timothyosm/tifa6-acrylic-speaker/docs/current/hardware.md

# Hardware for one enclosure

Current build: **72 M3 screws** (56 x M3-16, 8 x M3-10, 4 x M3-20, 4 x M3-6), 60 inserts and 4 nuts. Lengths are under-head dimensions in mm. Use ordinary socket/button heads, never countersunk; verify head fit in the real driver recesses.

| Qty | Item | Purpose |
|---:|---|---|
| 32 | M3 x 16 screw | Side/front/rear to rails |
| 8 | M3 x 16 screw | Top/bottom to rails |
| 4 | M3 x 16 screw | Brace to shelves |
| 8 | M3 x 16 screw | Adapters to front |
| 4 | M3 x 16 screw | Rear to crossover spacers |
| 8 | M3 x 10 screw | Drivers |
| 4 | M3 x 20 screw | Port flange |
| 4 | M3 x 6 screw | Crossover board |
| 60 | M3 heat-set insert, 4 mm long | Printed fittings; 4.2 mm pilots |
| 4 | M3 plain nut | Port flange |
| 64 | 9 mm OD M3 flat washer | 60 sheet-side heads + 4 port flange rear washers |
| 60 | Compatible cushioning washer | Sheet-side heads; metal+cushion stack 1.5 mm |
| 4 | M3 female/female 20 mm spacer | Crossover |
| 2 | Insulated binding post for 8 mm opening | Own nuts and seals |
| 1 | 120 x 90 x 2 insulating board | 100 x 70 mm mounting pattern |

Also supply compatible closed-cell foam, thin driver gaskets, removable sealant, porous lining and wire. All panel assembly uses M3 screws; no structural glue is required. Select the actual washers to give the modelled 1.5 mm head-side metal/cushion stack. Inserts are 4 mm long in 4.2 mm pilots. Test retention and tighten gently; no torque rating has been physically qualified. Binding posts use their own supplied hardware.
