timothyosm/tifa6-acrylic-speaker/docs/source-register.md

# Sources

- [Tifa 6 cabinet drawing](https://sbacoustics.com/wp-content/uploads/2026/05/Tifa-6-cabinet-drawing.pdf): cabinet baseline, driver positions and port.
- [SB16PFCR25-4](https://sbacoustics.com/wp-content/uploads/2024/01/6in-SB16PFCR25-4.pdf): woofer dimensions.
- [SB26ST-C000-5](https://sbacoustics.com/wp-content/uploads/2020/02/SB26ST-C000-5.pdf): tweeter dimensions.
- [Tifa 6 crossover](https://sbacoustics.com/wp-content/uploads/2025/12/Tifa-6-Crossover-Schematic.pdf): unchanged electrical design.

Manufacturer PDFs are available at the official links above; local reference copies are not redistributed in this repository. Hardware fits are nominal and need a physical dry fit.

## Acrylic fabrication

- [PLEXIGLAS drilling guidance](https://www.plexiglas.de/en/service/processing/drilling-plexiglas): minimum hole-centre edge distance of 1.5 times hole diameter; appropriate drilling methods for the actual sheet.
- [PLEXIGLAS fastening guidance](https://www.plexiglas.de/en/service/processing/fastening-and-laying-plexiglas): allow thermal movement and use compatible fastening methods.
- [Perspex design guide](https://www.perspex.co.uk/Perspex/media/General/technical-library/PDFs/Perspex-Design-Guide.pdf): acrylic design and fabrication reference. Confirm actual grade and fabricator requirements.

The rectangular 220 mm baffle, 10 mm acrylic panels, lower port position, printed adapters and M3 rails are project adaptations. The flat panel STLs provide dimensional references. Profiles are uncompensated; measured sheet thickness and laser kerf must be confirmed using the supplied coupon. No physical acoustic equivalence to the original cabinet is claimed.
