timothyosm/tifa6-acrylic-speaker/renders/exploded.png

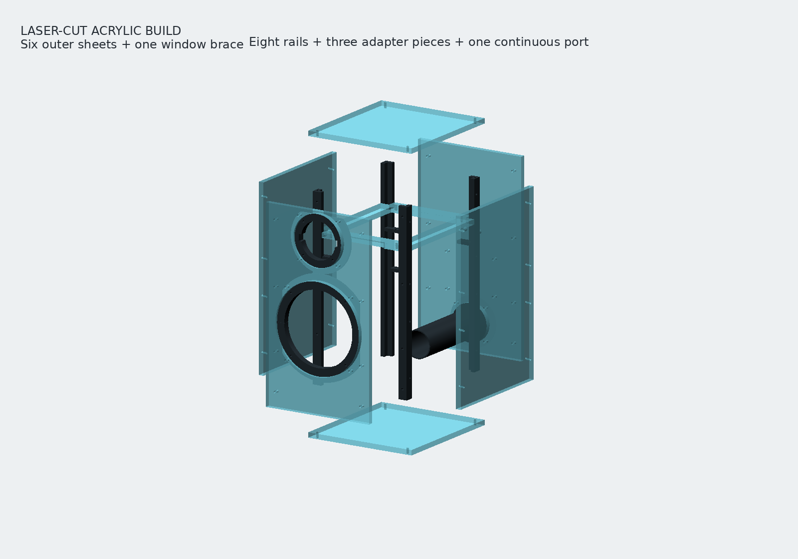
renders/exploded.png
