timothyosm/tifa6-acrylic-speaker/renders/rear.png

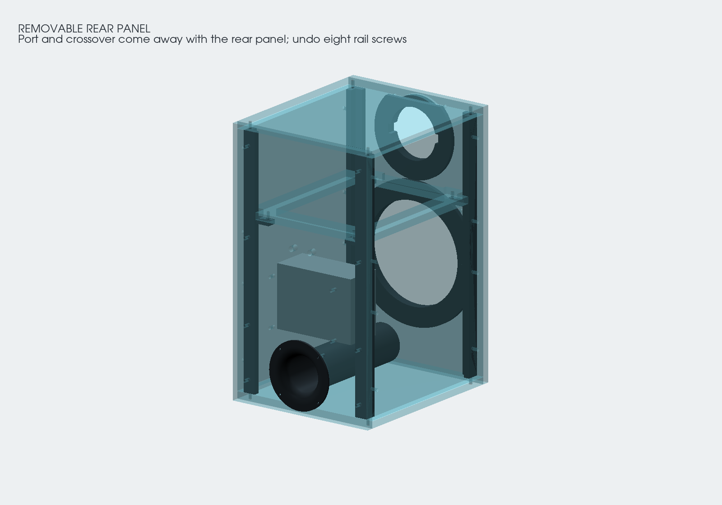
renders/rear.png
