timothyosm/tifa6-acrylic-speaker/renders/sectional.png

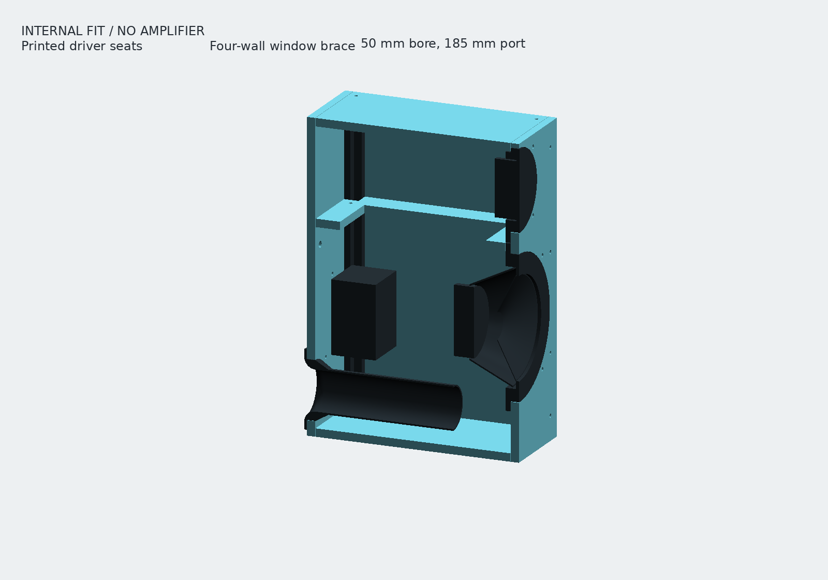
renders/sectional.png
