timothyosm/tifa6-acrylic-speaker/exports/current/print-manifest.csv

file | quantity | kind | size_x_mm | size_y_mm | size_z_mm
front.stl | 1 | sheet | 220.0 | 380.0 | 10.0
rear.stl | 1 | sheet | 220.0 | 380.0 | 10.0
left.stl | 1 | sheet | 241.65216064453125 | 359.0 | 10.0
right.stl | 1 | sheet | 241.65216064453125 | 359.0 | 10.0
bottom.stl | 1 | sheet | 220.0 | 241.65216064453125 | 10.0
top.stl | 1 | sheet | 220.0 | 241.65216064453125 | 10.0
brace.stl | 1 | sheet | 199.0 | 240.65216064453125 | 10.0
rail_left_front_lower.stl | 1 | printed_fitting | 139.6535949707031 | 139.65359497070312 | 18.0
rail_left_front_upper.stl | 1 | printed_fitting | 139.65359497070312 | 139.65359497070312 | 38.0
rail_left_rear_lower.stl | 1 | printed_fitting | 139.65359497070312 | 139.65359497070312 | 18.0
rail_left_rear_upper.stl | 1 | printed_fitting | 139.65359497070312 | 139.65359497070312 | 38.0
rail_right_front_lower.stl | 1 | printed_fitting | 139.65359497070312 | 139.65359497070312 | 18.0
rail_right_front_upper.stl | 1 | printed_fitting | 139.65359497070312 | 139.65359497070312 | 38.0
rail_right_rear_lower.stl | 1 | printed_fitting | 139.65359497070312 | 139.65359497070312 | 18.0
rail_right_rear_upper.stl | 1 | printed_fitting | 139.65359497070312 | 139.65359497070312 | 38.0
tweeter_adapter.stl | 1 | printed_fitting | 125.99989093116892 | 112.98756784386933 | 13.5
woofer_adapter_lower.stl | 1 | printed_fitting | 175.99989318847656 | 99.9000015258789 | 12.899999618530273
woofer_adapter_upper.stl | 1 | printed_fitting | 175.99989318847656 | 99.9000015258789 | 12.899999618530273
bass_reflex_port.stl | 1 | printed_fitting | 96.0 | 95.98102086223662 | 184.99999989999998
