timothyosm/tifa6-acrylic-speaker/cad/speaker_assembly.FCStd

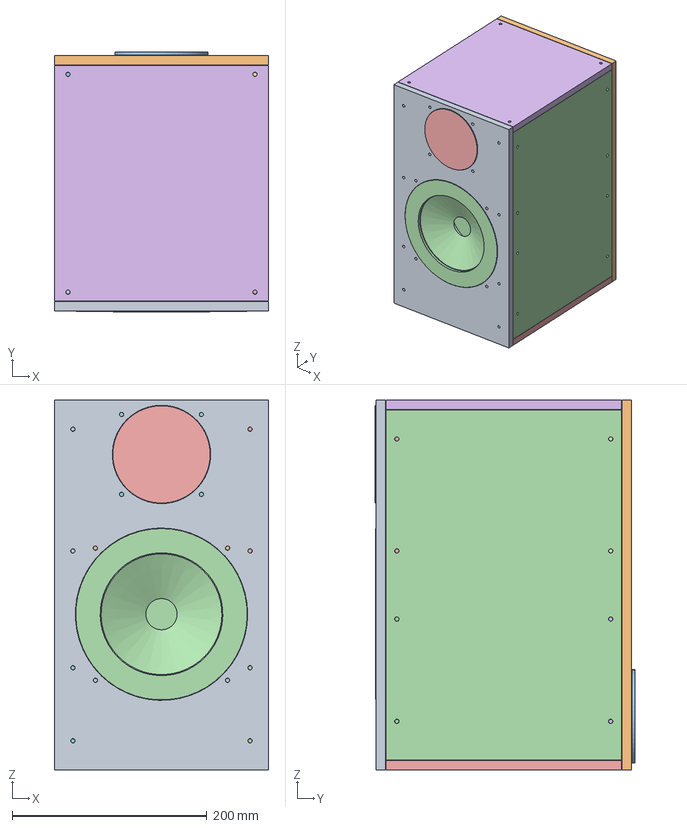
[picture p5: CAD file, 2026-10-10]
cad/speaker_assembly.FCStd
220.0 x 267.2 x 380.0 mm
front
rear
left
right
bottom
top
brace
rail_left_front_lower
rail_left_front_upper
rail_left_rear_lower
rail_left_rear_upper
rail_right_front_lower
rail_right_front_upper
rail_right_rear_lower
rail_right_rear_upper
tweeter_adapter
woofer_adapter_lower
woofer_adapter_upper
bass_reflex_port
reference_woofer
reference_tweeter
reference_crossover
reference_spacers
