timothyosm/tifa6-acrylic-speaker/exports/current/step/enclosure_assembly.step

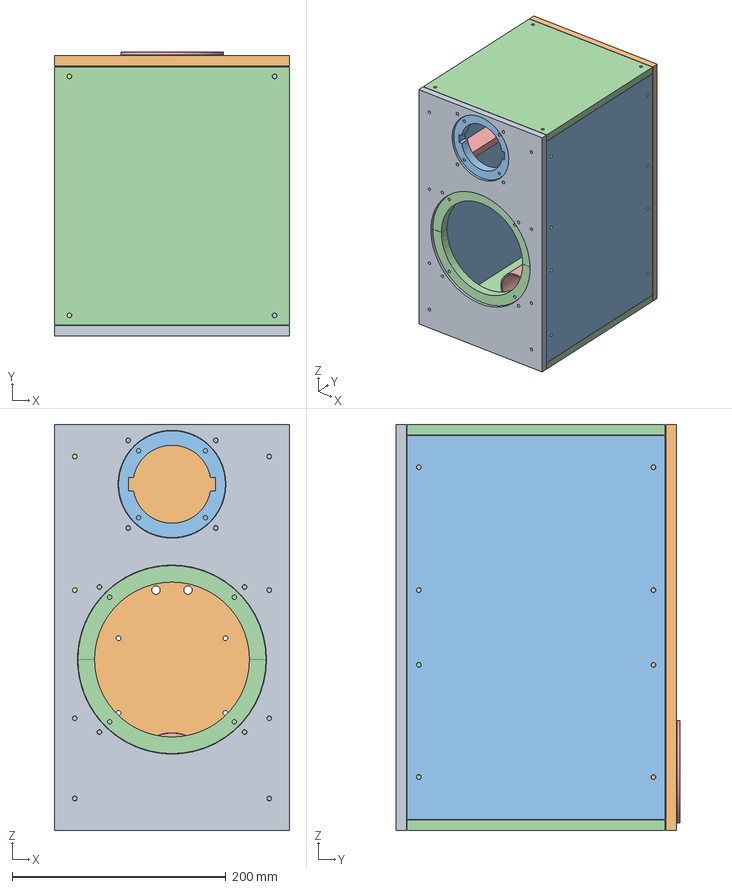
[picture p6: CAD file, 2026-10-10]
exports/current/step/enclosure_assembly.step
220.0 x 266.2 x 380.0 mm
