timothyosm/tifa6-acrylic-speaker/exports/calibration/laser/sheet_fit_coupon.dxf

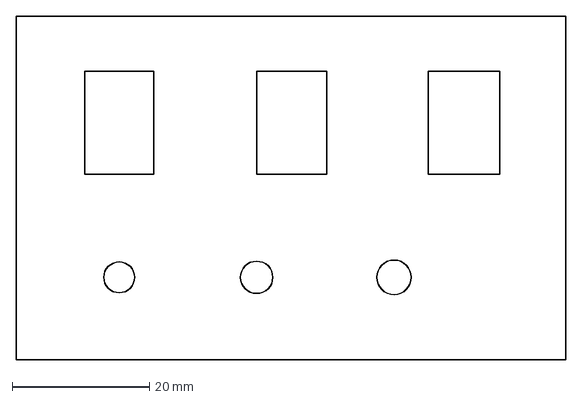
[picture p7: CAD file, 2026-10-10]
exports/calibration/laser/sheet_fit_coupon.dxf
80.0 x 50.0 mm
