timothyosm/tifa6-acrylic-speaker/exports/calibration/stl/sheet_fit_coupon.stl

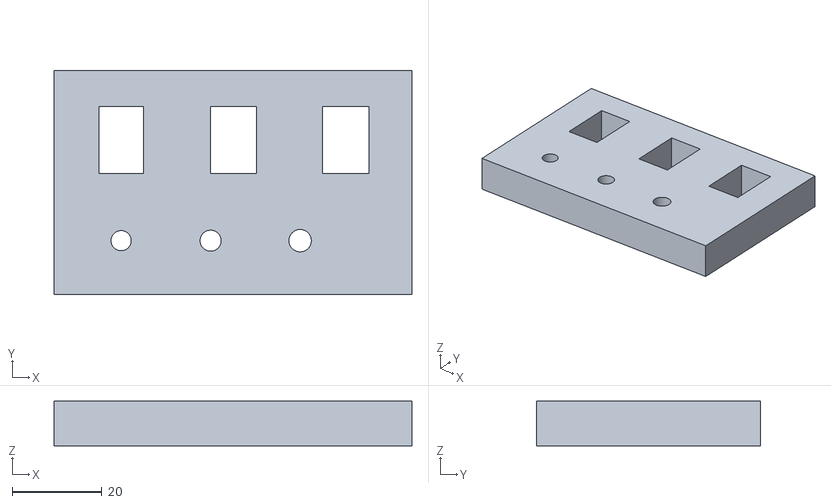
[picture p8: CAD file, 2026-10-10]
exports/calibration/stl/sheet_fit_coupon.stl
80.0 x 50.0 x 10.0
