timothyosm/tifa6-acrylic-speaker/exports/current/laser/brace.dxf

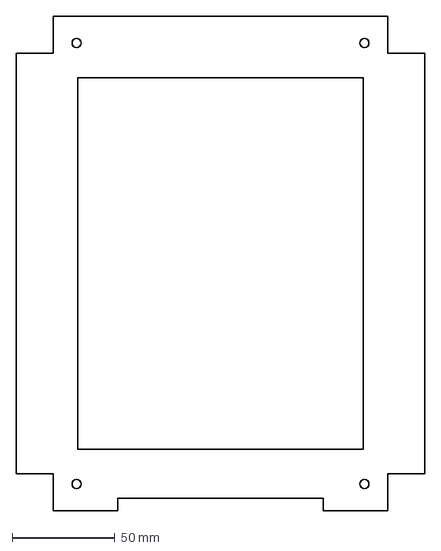
[picture p9: CAD file, 2026-10-10]
exports/current/laser/brace.dxf
199.0 x 240.7 mm
