timothyosm/tifa6-acrylic-speaker/exports/current/step/top.step

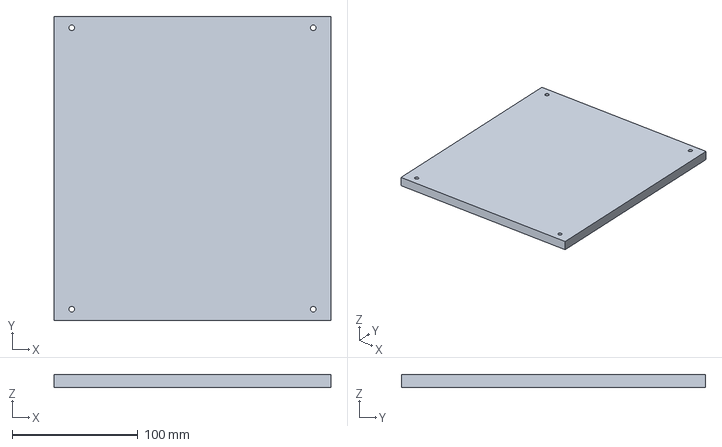
[picture p10: CAD file, 2026-10-10]
exports/current/step/top.step
220.0 x 241.7 x 10.0 mm
