timothyosm/tifa6-acrylic-speaker/exports/current/laser/left.dxf

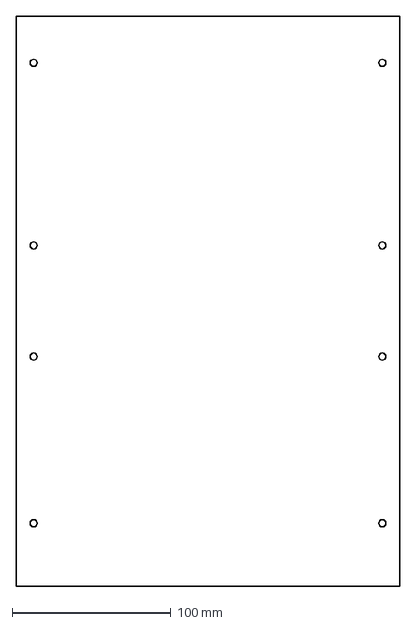
[picture p11: CAD file, 2026-10-10]
exports/current/laser/left.dxf
241.7 x 359.0 mm
