timothyosm/tifa6-acrylic-speaker/exports/current/step/rail_left_rear_lower.step

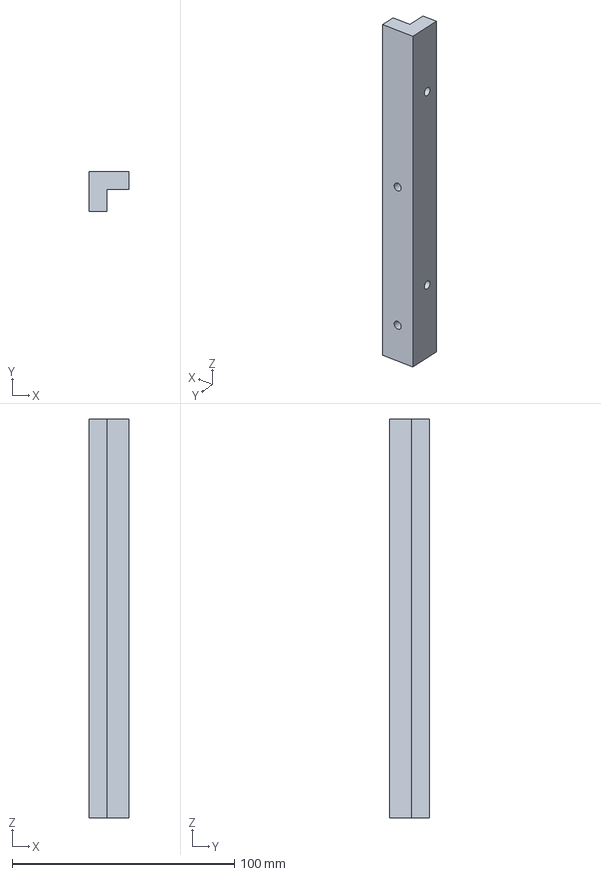
[picture p12: CAD file, 2026-10-10]
exports/current/step/rail_left_rear_lower.step
18.0 x 18.0 x 179.5 mm
