timothyosm/tifa6-acrylic-speaker/exports/current/laser/right.dxf

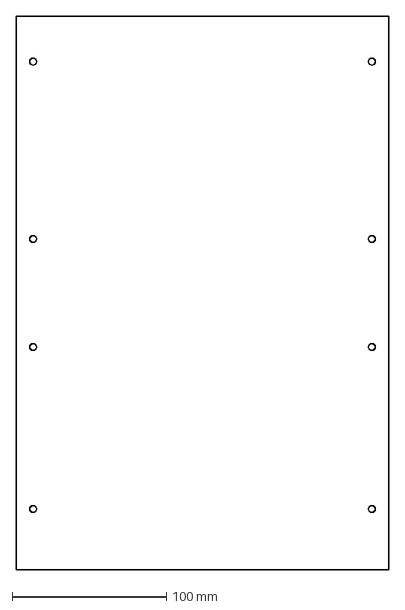
[picture p13: CAD file, 2026-10-10]
exports/current/laser/right.dxf
241.7 x 359.0 mm
