timothyosm/tifa6-acrylic-speaker/exports/current/step/reference_tweeter.step

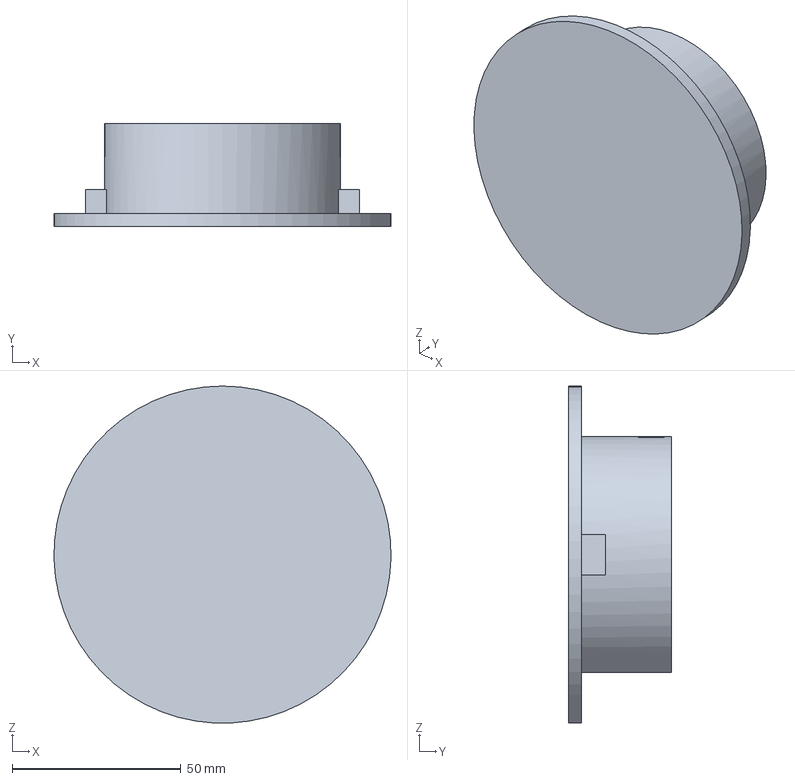
[picture p14: CAD file, 2026-10-10]
exports/current/step/reference_tweeter.step
100.0 x 30.7 x 99.9 mm
