timothyosm/tifa6-acrylic-speaker/exports/current/laser/bottom.dxf

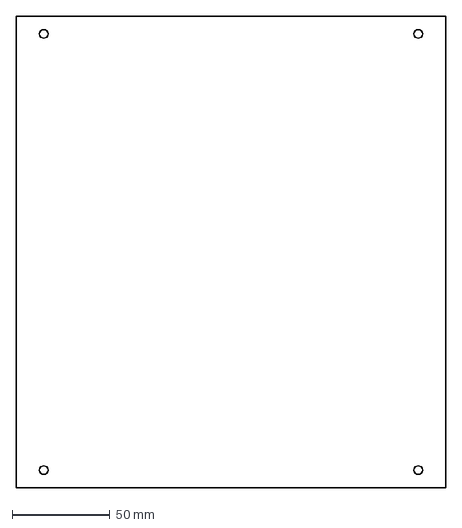
[picture p15: CAD file, 2026-10-10]
exports/current/laser/bottom.dxf
220.0 x 241.7 mm
