timothyosm/tifa6-acrylic-speaker/exports/current/step/reference_crossover.step

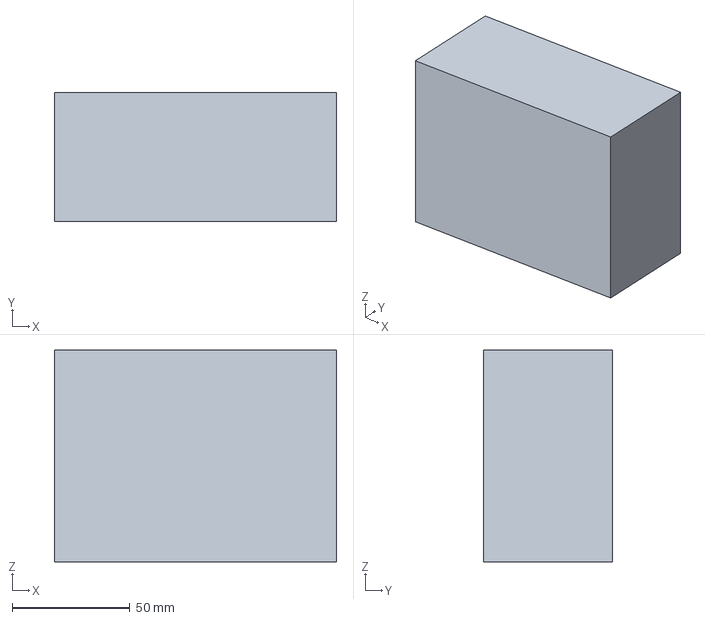
[picture p16: CAD file, 2026-10-10]
exports/current/step/reference_crossover.step
120.0 x 55.0 x 90.0 mm
