timothyosm/tifa6-acrylic-speaker/exports/current/laser/top.dxf

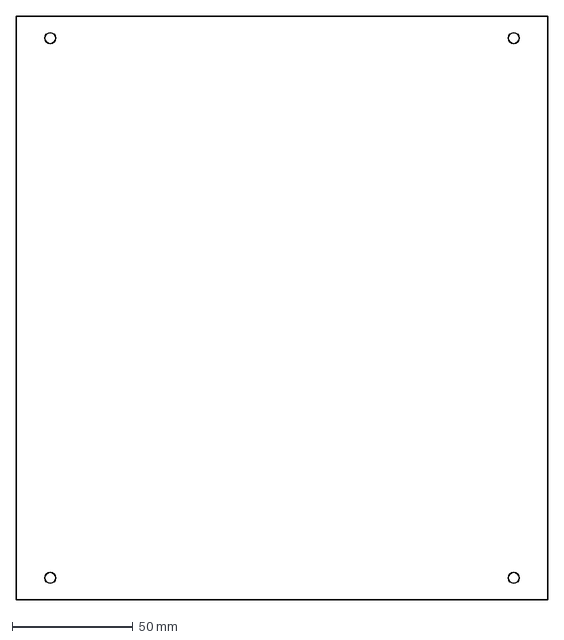
[picture p17: CAD file, 2026-10-10]
exports/current/laser/top.dxf
220.0 x 241.7 mm
