timothyosm/tifa6-acrylic-speaker/exports/current/step/reference_spacers.step

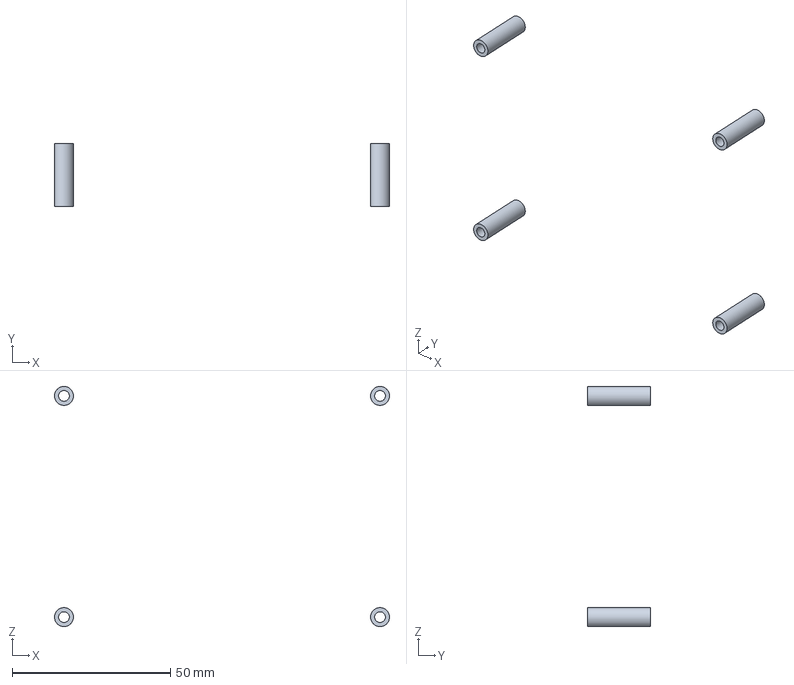
[picture p18: CAD file, 2026-10-10]
exports/current/step/reference_spacers.step
106.0 x 20.0 x 76.0 mm
