timothyosm/tifa6-acrylic-speaker/exports/current/laser/front.dxf

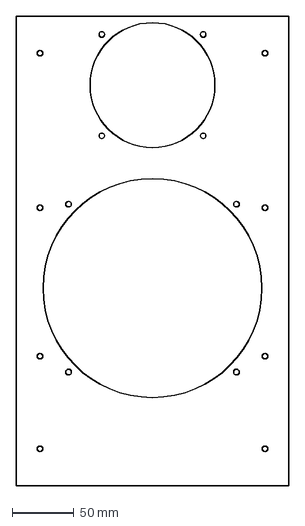
[picture p19: CAD file, 2026-10-10]
exports/current/laser/front.dxf
220.0 x 380.0 mm
