timothyosm/tifa6-acrylic-speaker/exports/current/step/woofer_adapter_upper.step

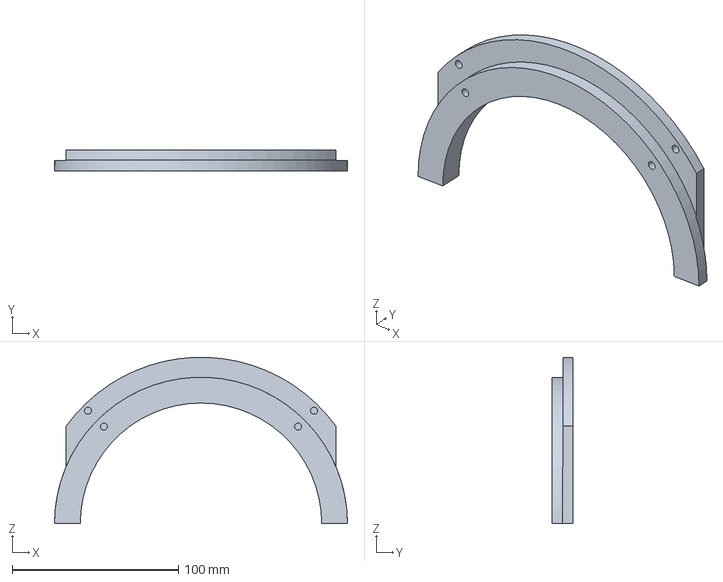
[picture p20: CAD file, 2026-10-10]
exports/current/step/woofer_adapter_upper.step
176.0 x 12.9 x 99.8 mm
