timothyosm/tifa6-acrylic-speaker/exports/current/laser/rear.dxf

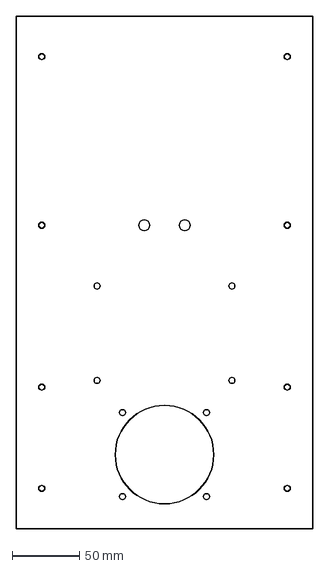
[picture p21: CAD file, 2026-10-10]
exports/current/laser/rear.dxf
220.0 x 380.0 mm
