timothyosm/tifa6-acrylic-speaker/exports/current/step/rail_right_rear_upper.step

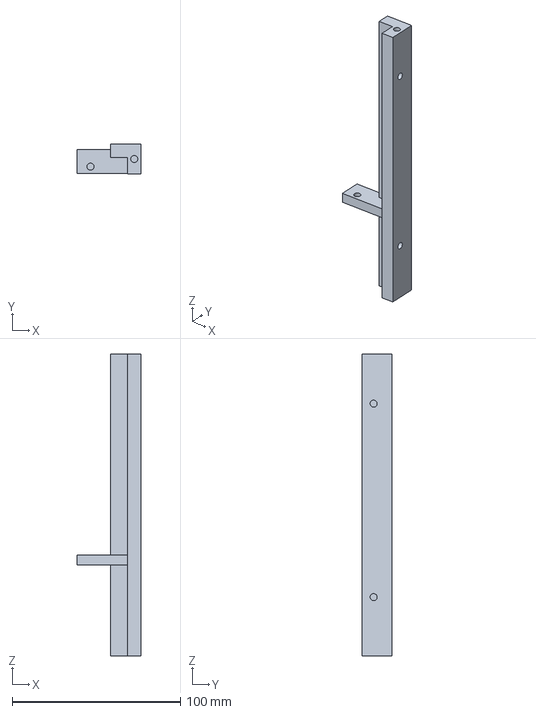
[picture p22: CAD file, 2026-10-10]
exports/current/step/rail_right_rear_upper.step
38.0 x 18.0 x 179.5 mm
