timothyosm/tifa6-acrylic-speaker/exports/current/step/rear.step

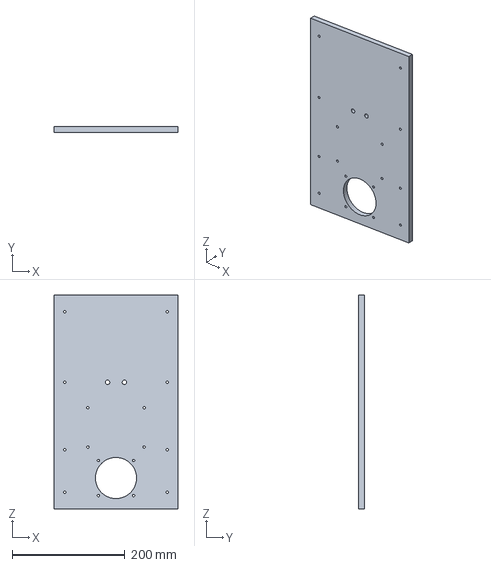
[picture p23: CAD file, 2026-10-10]
exports/current/step/rear.step
220.0 x 10.00 x 380.0 mm
