timothyosm/tifa6-acrylic-speaker/exports/current/step/brace.step

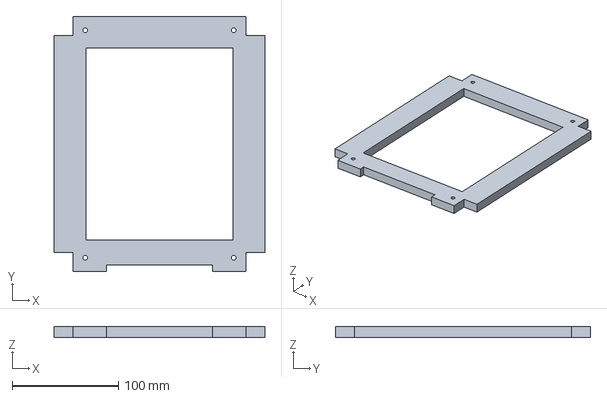
[picture p24: CAD file, 2026-10-10]
exports/current/step/brace.step
199.0 x 240.7 x 10.0 mm
