timothyosm/tifa6-acrylic-speaker/exports/current/step/nominal_air_volume.step

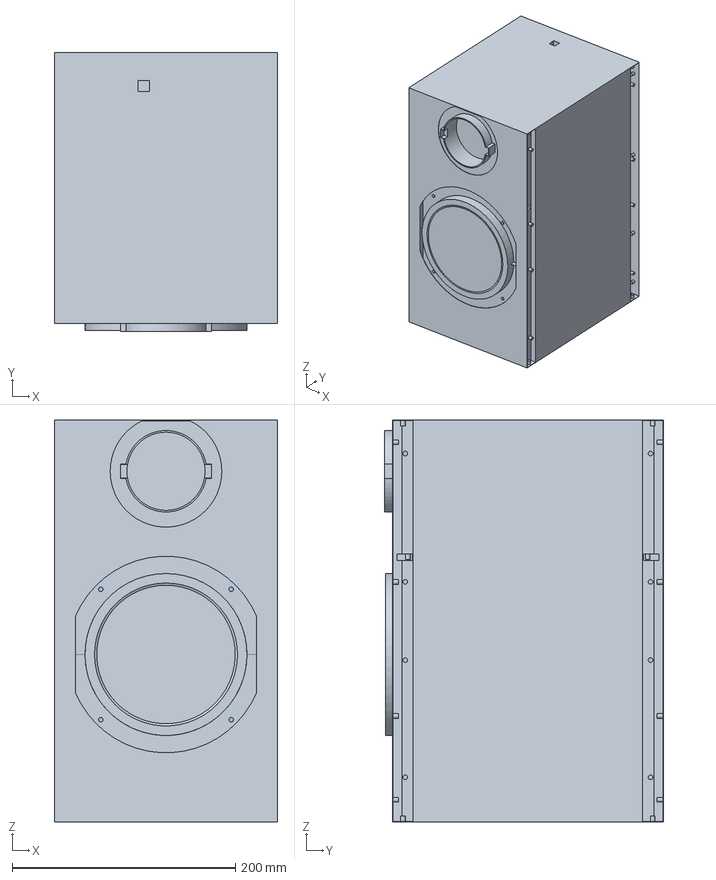
[picture p25: CAD file, 2026-10-10]
exports/current/step/nominal_air_volume.step
200.0 x 249.7 x 360.0 mm
