timothyosm/tifa6-acrylic-speaker/exports/current/step/left.step

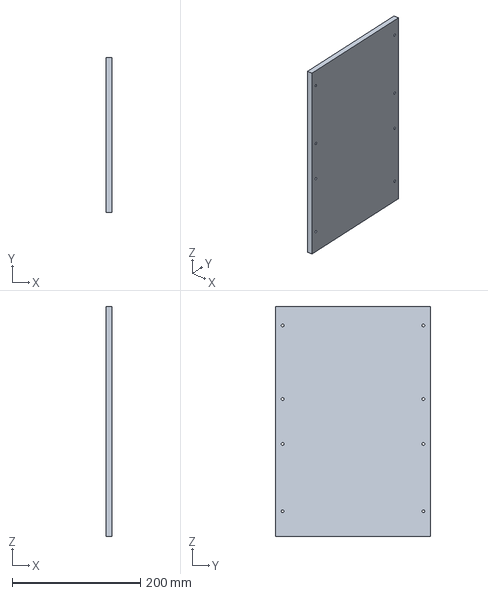
[picture p26: CAD file, 2026-10-10]
exports/current/step/left.step
10.0 x 241.7 x 359.0 mm
