timothyosm/tifa6-acrylic-speaker/exports/current/step/tweeter_adapter.step

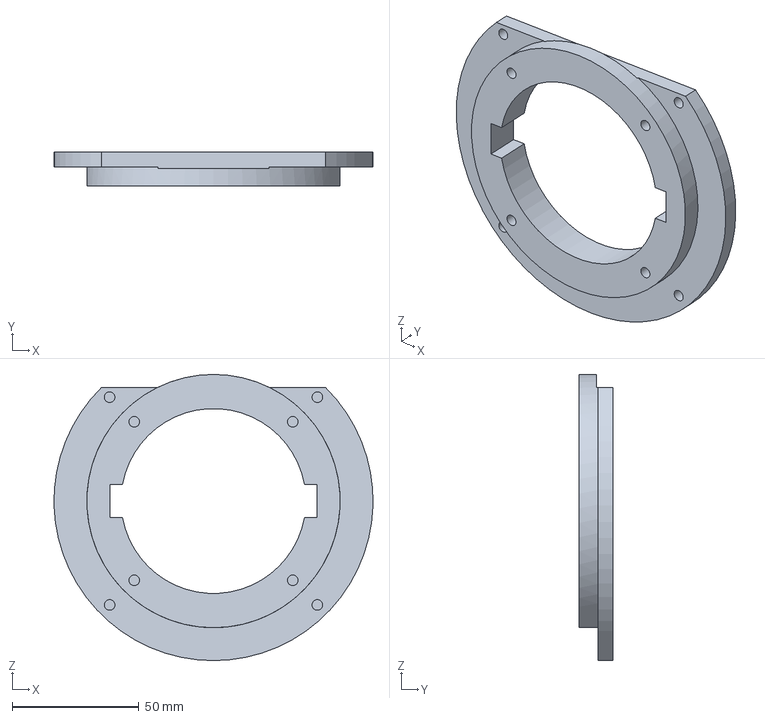
[picture p27: CAD file, 2026-10-10]
exports/current/step/tweeter_adapter.step
125.9 x 13.5 x 113.0 mm
