timothyosm/tifa6-acrylic-speaker/exports/current/step/front.step

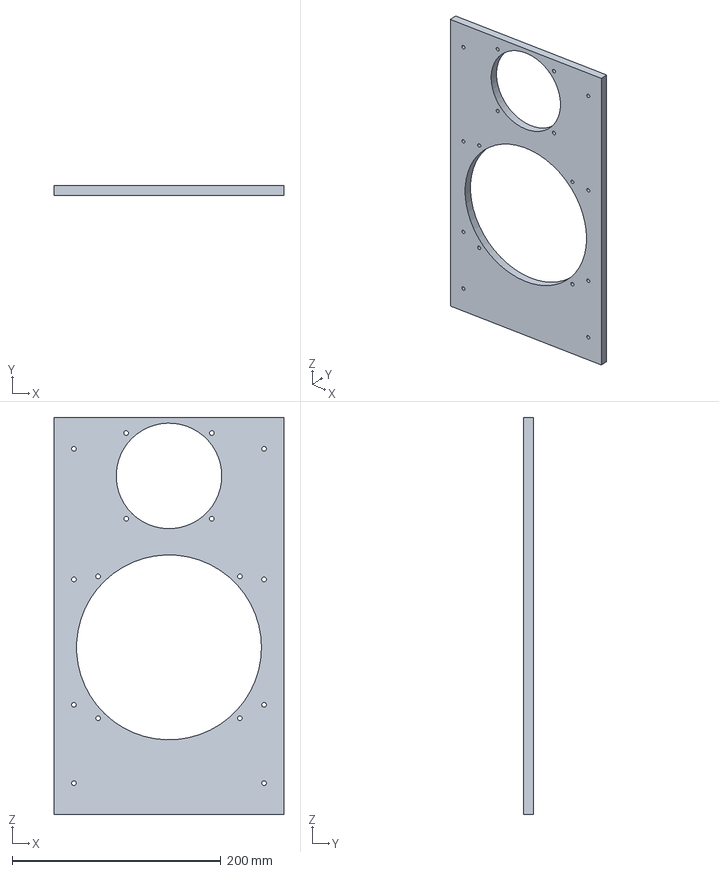
[picture p28: CAD file, 2026-10-10]
exports/current/step/front.step
220.0 x 10.0 x 380.0 mm
