timothyosm/tifa6-acrylic-speaker/exports/current/step/bass_reflex_port.step

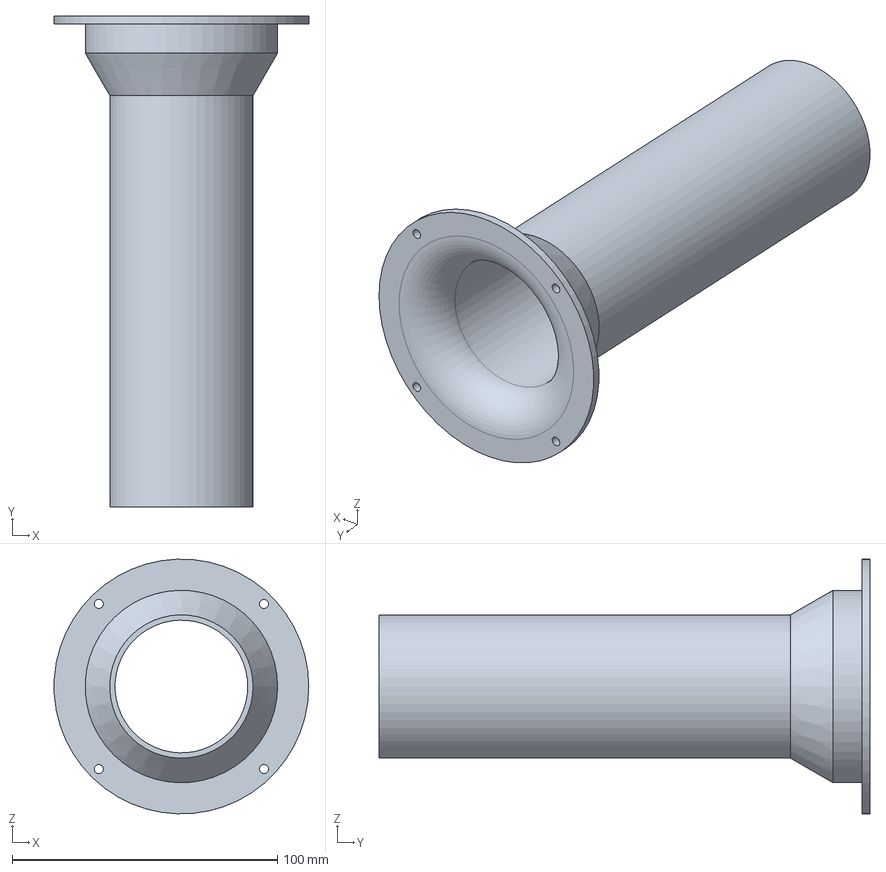
[picture p29: CAD file, 2026-10-10]
exports/current/step/bass_reflex_port.step
95.9 x 185.0 x 96.0 mm
