timothyosm/tifa6-acrylic-speaker/exports/current/step/reference_woofer.step

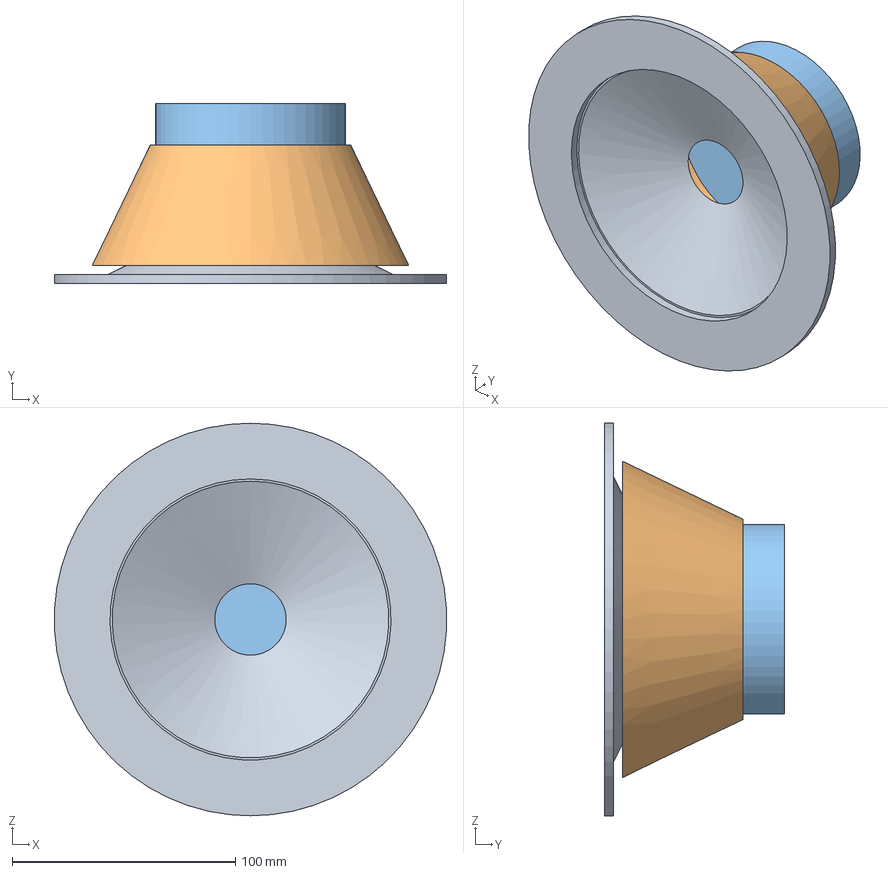
[picture p30: CAD file, 2026-10-10]
exports/current/step/reference_woofer.step
175.7 x 80.8 x 176.0 mm
