timothyosm/tifa6-acrylic-speaker/(list of files, cad)

Other CAD files:
exports/current/step/assembly_with_components.step
exports/current/step/rail_left_front_upper.step
exports/current/step/bottom.step
exports/current/step/rail_right_front_lower.step
exports/current/step/rail_left_front_lower.step
exports/current/step/rail_right_rear_lower.step
exports/current/step/rail_left_rear_upper.step
exports/current/step/woofer_adapter_lower.step
exports/current/step/rail_right_front_upper.step
exports/current/step/right.step
exports/current/stl/bass_reflex_port.stl
exports/current/stl/bottom.stl
exports/current/stl/brace.stl
exports/current/stl/front.stl
exports/current/stl/left.stl
exports/current/stl/rail_left_front_lower.stl
exports/current/stl/rail_left_front_upper.stl
exports/current/stl/rail_left_rear_lower.stl
exports/current/stl/rail_left_rear_upper.stl
exports/current/stl/rail_right_front_lower.stl
exports/current/stl/rail_right_front_upper.stl
exports/current/stl/rail_right_rear_lower.stl
exports/current/stl/rail_right_rear_upper.stl
exports/current/stl/rear.stl
exports/current/stl/right.stl
exports/current/stl/top.stl
exports/current/stl/tweeter_adapter.stl
exports/current/stl/woofer_adapter_lower.stl
exports/current/stl/woofer_adapter_upper.stl
