timothyosm/tifa6-acrylic-speaker/renders/assembled.png

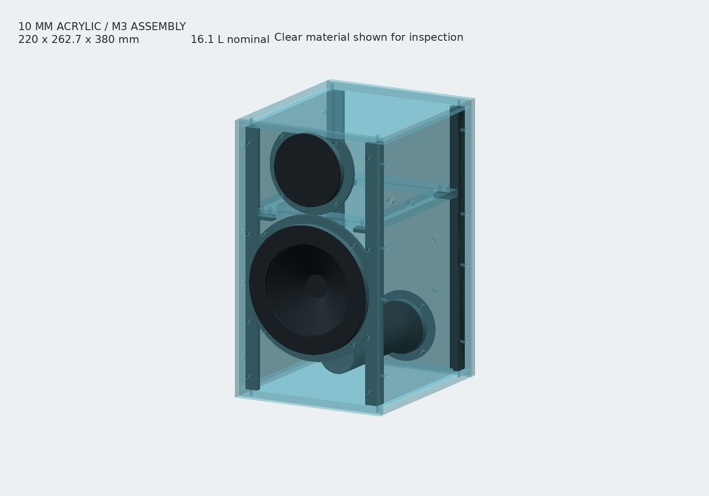
renders/assembled.png
