timothyosm/tifa6-acrylic-speaker/docs/current/verification-and-acoustics.md

# Verification and acoustic limits

The current build is 220 W x 380 H x 262.652 D mm, excluding driver/port/screw protrusions. It retains the original SB16PFCR25-4 woofer, SB26ST-C000-5 tweeter and passive Tifa 6 crossover. Driver centres are z160 and z324.1 (164.1 mm spacing), with printed seats at 3.6 and 3.0 mm depth.

Nominal net volume is approximately 16.115 litres with the continuous port. The saved air solid and volume ledger are in the STEP exports and validation report. Driver, crossover, wire and metal hardware displacement are estimates, so this is not a measured finished-cabinet volume.

The one-piece port preserves 50 mm bore, 185 mm axial length, R14 flare, 72.5 mm spigot and four M3 holes on 88 mm PCD. It fits the 73 mm rear-panel opening and retains a 71.15 mm inlet approach to the front wall. Its centre is z55. Its mounting uses four M3 x20 screws; no coupling fasteners remain.

The current meshes are connected and watertight. The generated panel profiles, screw paths, head/washer clearances and insert engagement are checked against the assembly. The port clears the approximate driver/crossover envelopes. Both the STEP and native FreeCAD assemblies contain the continuous port.

The flat 220 mm-wide baffle differs from the original tapered 180-220 mm, 6-degree tilted baffle. Diffraction, time alignment and crossover summation can differ; acrylic also differs from the original wood cabinet in stiffness and damping. Retain the specified crossover values and polarity, but do not assume identical sound. Original nominal tuning is about 37 Hz; actual tuning of this cabinet requires measurement.

Still outstanding: physical printing, laser cutting, fit, hand/tool access, seal compression, insert retention, leakage, structural behaviour and acoustic measurements. A dimensional model does not establish acrylic acoustic performance. Do not remove the four-wall brace.
