timothyosm/tifa6-acrylic-speaker/(commit log)

2026-10-10 Publish Tifa 6 acrylic enclosure with current whole-panel build
    [assembly_with_components.step, bass_reflex_port.step, bass_reflex_port.stl, bottom.dxf, bottom.step, bottom.stl, bottom_11.dxf, bottom_11.step]
2026-10-10 Remove prototype variants and keep the acrylic manufacturing build
    [assembly_with_components.step, bass_reflex_port.step, bass_reflex_port.stl, bottom.dxf, bottom.step, bottom.stl, bottom_11.dxf, bottom_11.step]
